ElieAuriol/ClignoSecure/IMAGES/Montage_entier.jpg

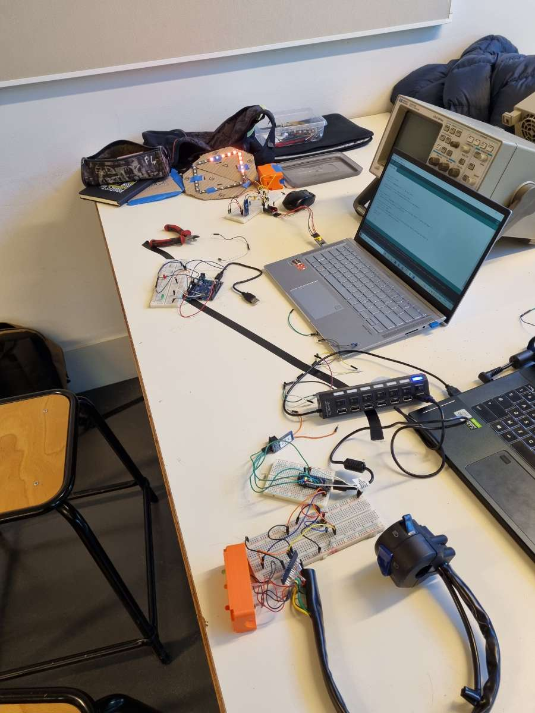
IMAGES/Montage_entier.jpg
