ElieAuriol/ClignoSecure/IMAGES/Boitier_Velcro.jpg

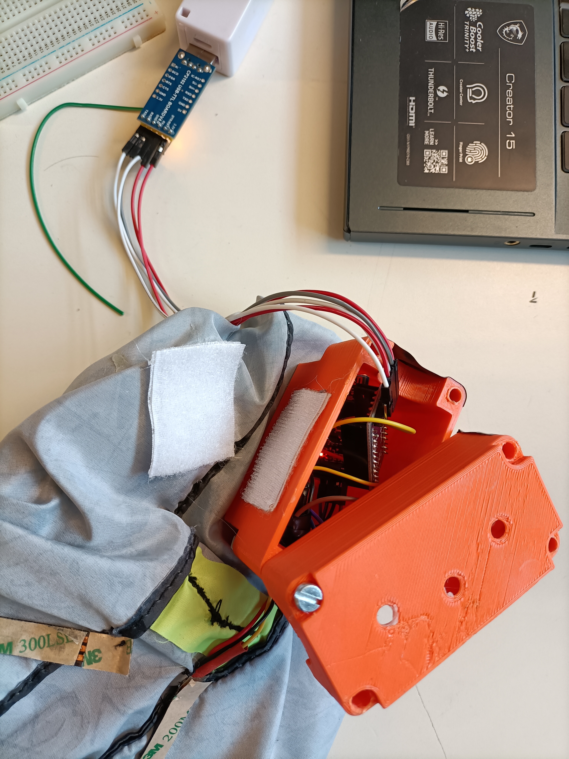
IMAGES/Boitier_Velcro.jpg
