ElieAuriol/ClignoSecure/README.md

# Projet-Gilet-Arduino
Gilet de sécurité connecté pour tous les utilisateurs de vélos ou trottinettes.
