ElieAuriol/ClignoSecure/RAPPORTS/DONOSO LISKA Victor/Semaine 2.pdf

Donoso Liska Victor | Semaine 2 (16/12/2021)

### CLIGNOSECURE

### Rapport de Séance

Lors de cette deuxième séance de projet, mon binôme Elie Auriol et moi-même avons continué nos travaux individuels commencés lors de la première séance. En effet pendant que mon binôme continuait de comprendre le fonctionnement et la programmation des LED, je continuais à programmer le module bluetooth.

Connection Maitre/Esclave module bluetooth :

Lors de la dernière séance j’avais rencontré de nombreux problèmes à cause des cartes arduino ce qui avait retardé mon avancement. Au début de cette 2ème séance j’ai réussi à régler le problème qui venait des cartes Arduino Uno (utilisées pour les test) je les ai donc changées par des nano et j’ai pu commencer à me pencher sur la connexion maitre et esclave.

Pour cela Mr Masson m’a beaucoup aidé. En effet une fois que j’avais fait le cablage et le code du maitre (HC-05) et du module esclave (HC-06), Mr Masson est venu pour m’aider a les connecter entre eux en suivant les étapes de son cours.

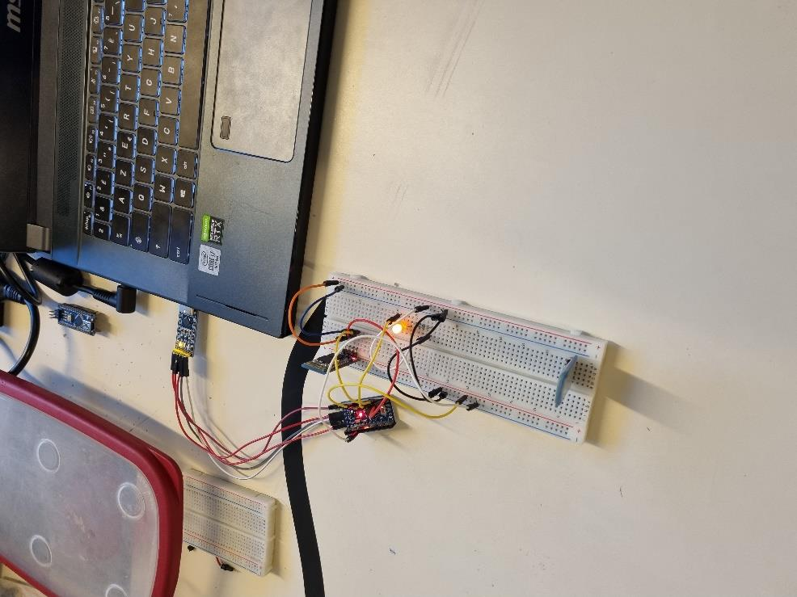
[picture p26: figure]

Sur l’image ci-dessus on peut voir le câblage du module Esclave, branché sur mon ordinateur.

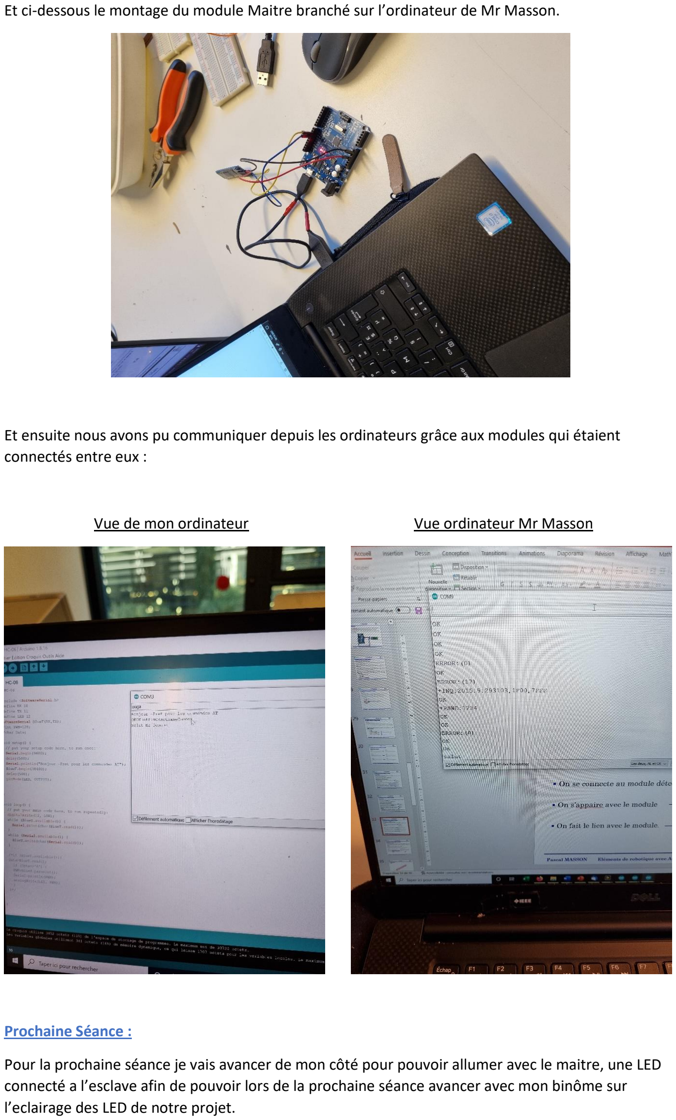
[picture p27: page 2]

Et ci-dessous le montage du module Maitre branché sur l’ordinateur de Mr Masson.

Et ensuite nous avons pu communiquer depuis les ordinateurs grâce aux modules qui étaient connectés entre eux :

Vue de mon ordinateur | Vue ordinateur Mr Masson

Prochaine Séance :

Pour la prochaine séance je vais avancer de mon côté pour pouvoir allumer avec le maitre, une LED connecté a l’esclave afin de pouvoir lors de la prochaine séance avancer avec mon binôme sur l’eclairage des LED de notre projet.
