ElieAuriol/ClignoSecure/IMAGES/Boitier_Guidon.jpg

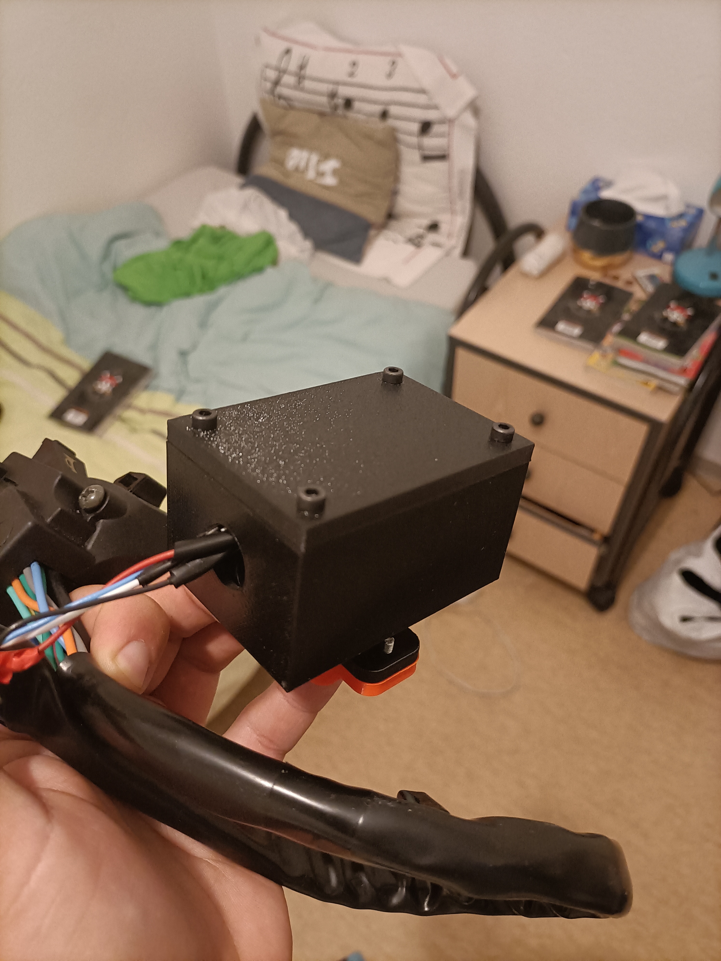
IMAGES/Boitier_Guidon.jpg
