ElieAuriol/ClignoSecure/IMAGES/Sac_avant.jpg

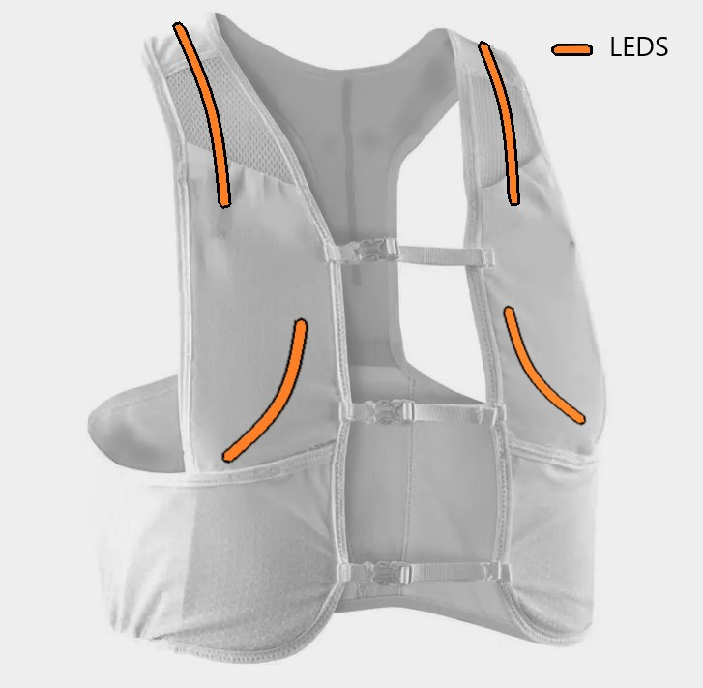
IMAGES/Sac_avant.jpg
