ElieAuriol/ClignoSecure/IMAGES/Sac_Interieur2.jpg

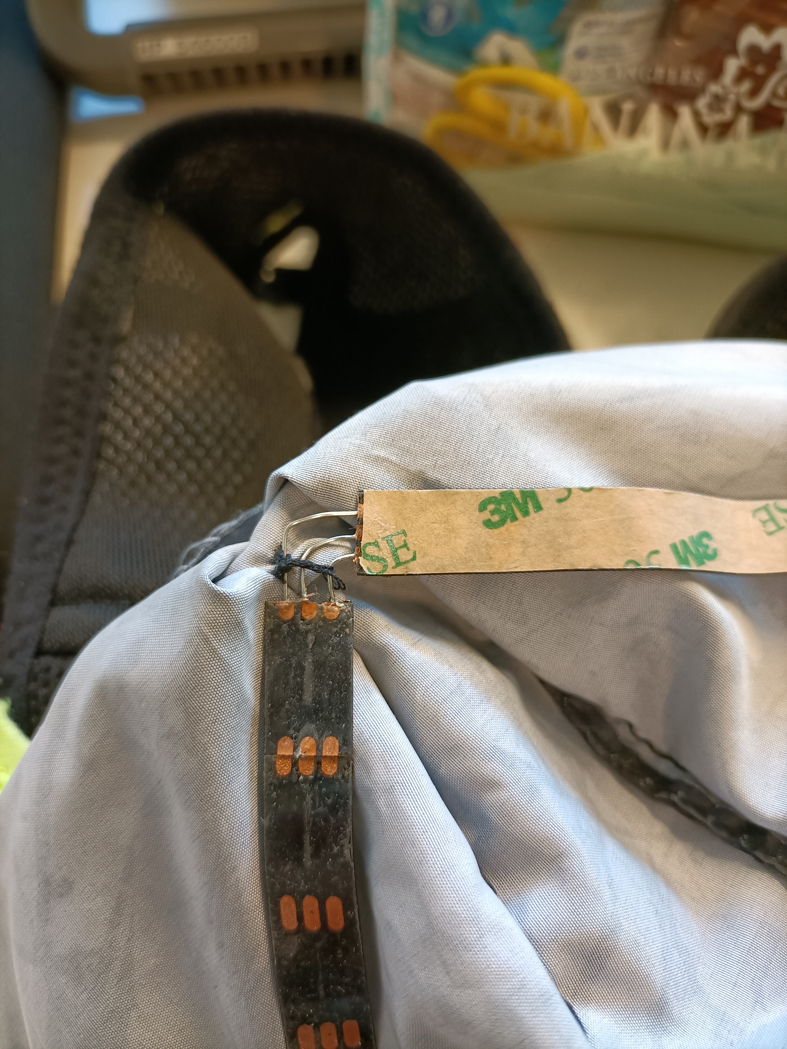
IMAGES/Sac_Interieur2.jpg
