ElieAuriol/ClignoSecure/IMAGES/Sac_Interieur.jpg

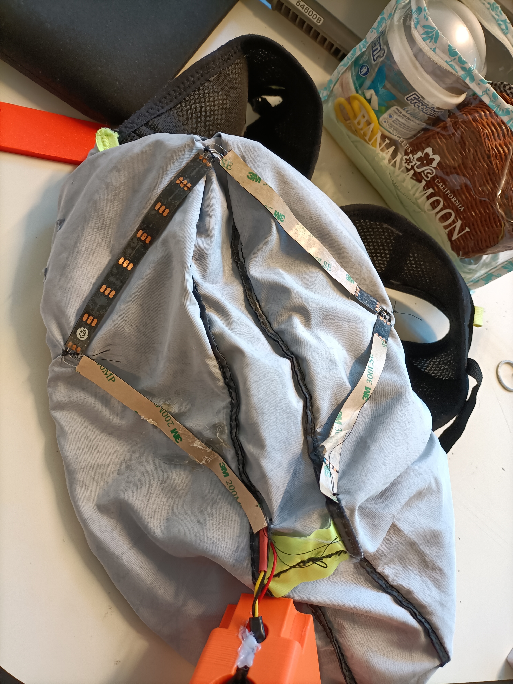
IMAGES/Sac_Interieur.jpg
