ElieAuriol/ClignoSecure/MODELISATIONS/Couvercle_1.stl

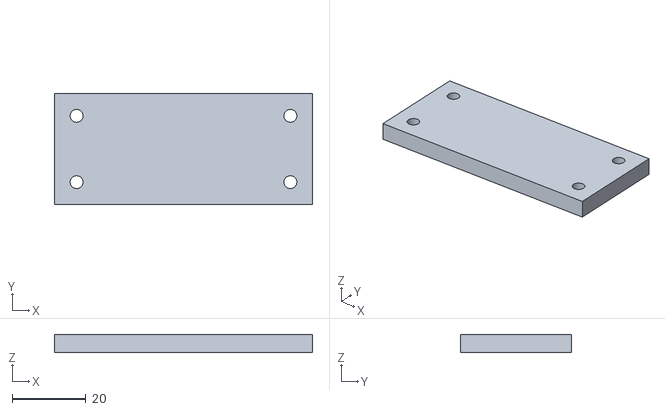
[picture p62: CAD file, 2022-02-28]
MODELISATIONS/Couvercle_1.stl
70.0 x 30.0 x 5.00
