ElieAuriol/ClignoSecure/MODELISATIONS/Couvercle_2.stl

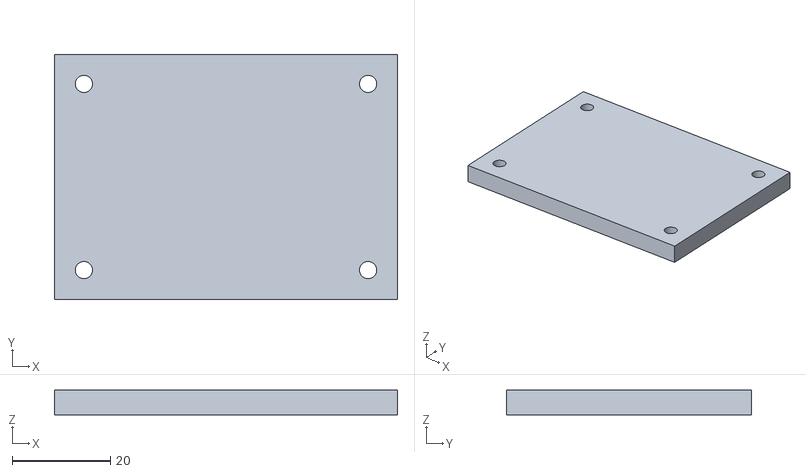
[picture p63: CAD file, 2022-02-28]
MODELISATIONS/Couvercle_2.stl
70.0 x 50.0 x 5.00
