ElieAuriol/ClignoSecure/MODELISATIONS/CollierSerrage_1.stl

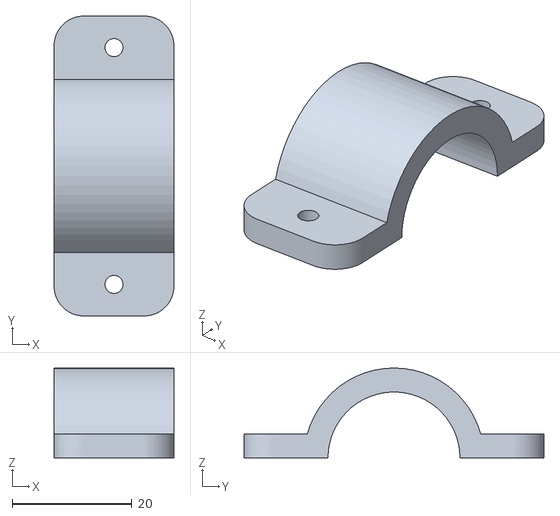
[picture p64: CAD file, 2022-02-28]
MODELISATIONS/CollierSerrage_1.stl
20.0 x 50.0 x 15.0
