ElieAuriol/ClignoSecure/MODELISATIONS/Boitier_2.stl

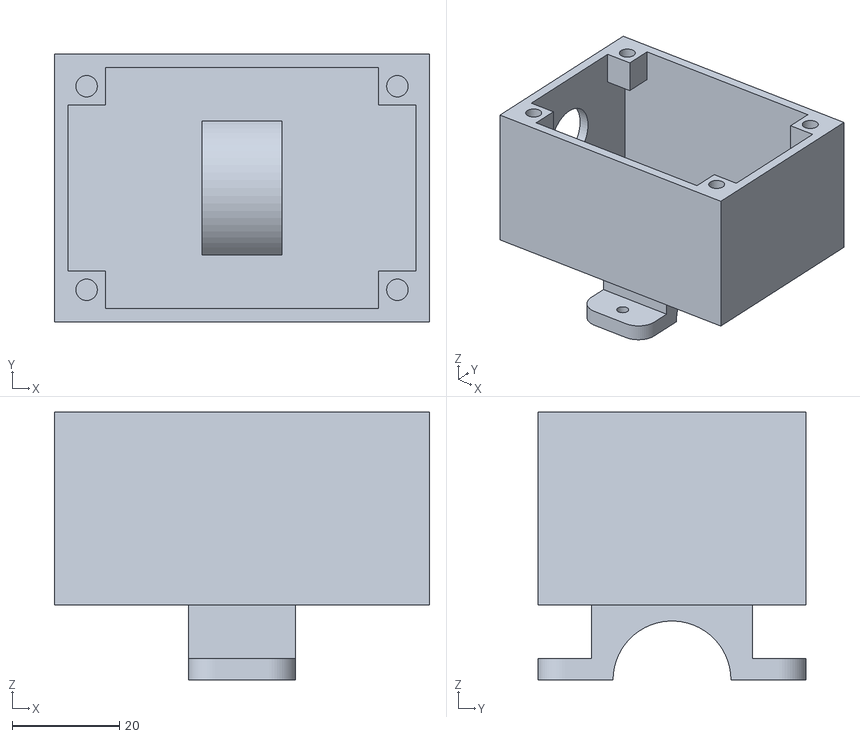
[picture p65: CAD file, 2022-02-28]
MODELISATIONS/Boitier_2.stl
70.0 x 50.0 x 50.0
