ElieAuriol/ClignoSecure/MODELISATIONS/Boitier_1.stl

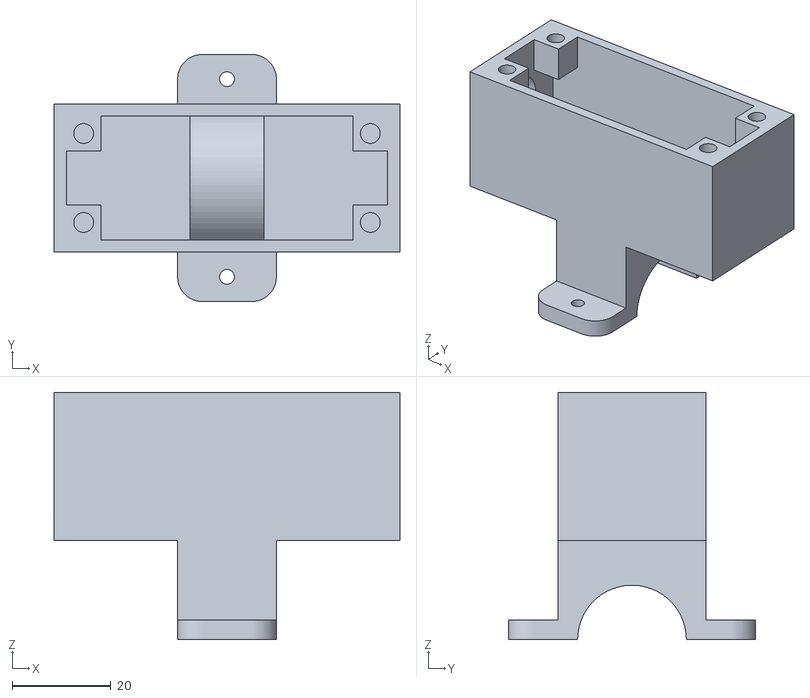
[picture p66: CAD file, 2022-02-28]
MODELISATIONS/Boitier_1.stl
70.0 x 50.0 x 50.0
